eligold/SDTV2CSI/README.md

# ADV7280A-M Pi Analog Video to MIPI CSI-2 Hardware
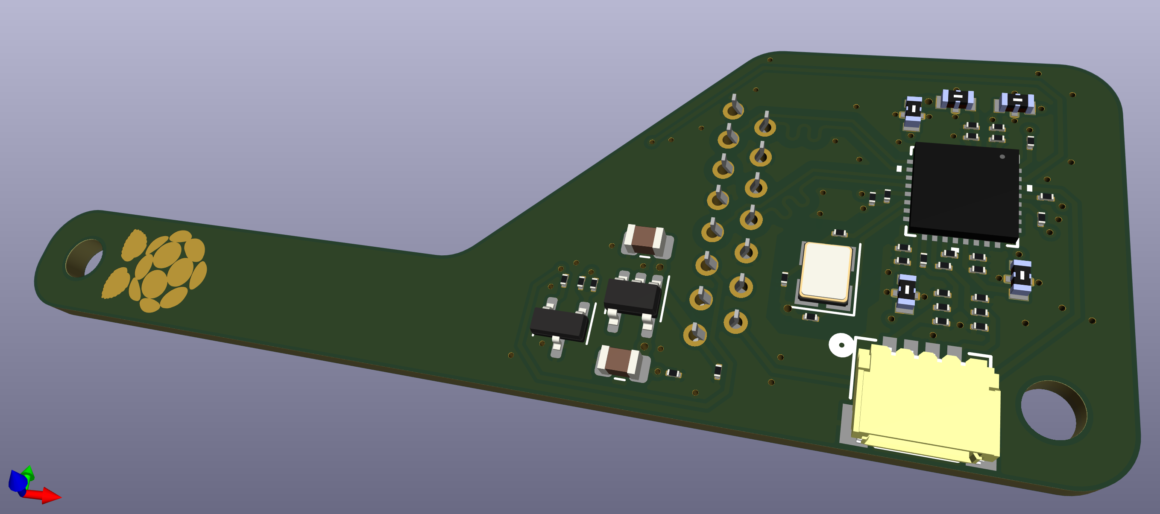
[picture p1: 3dstep.png]
3D view failed to load

<br>
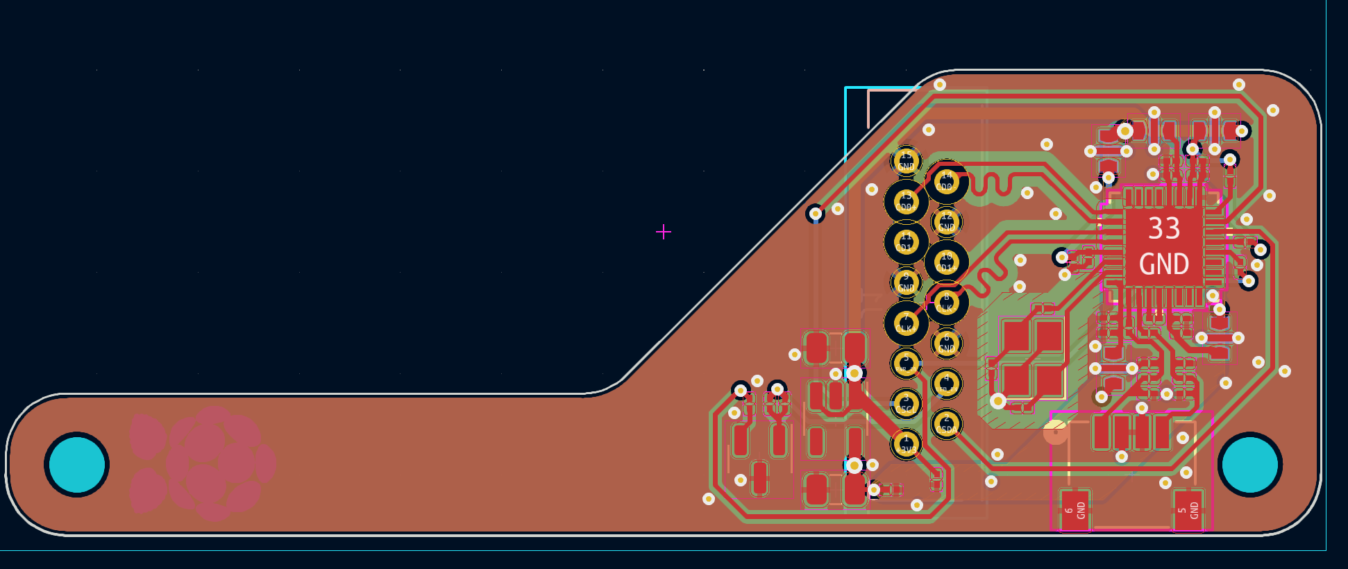
[picture p2: copperoutline.png]
copper image failed to load

<br>
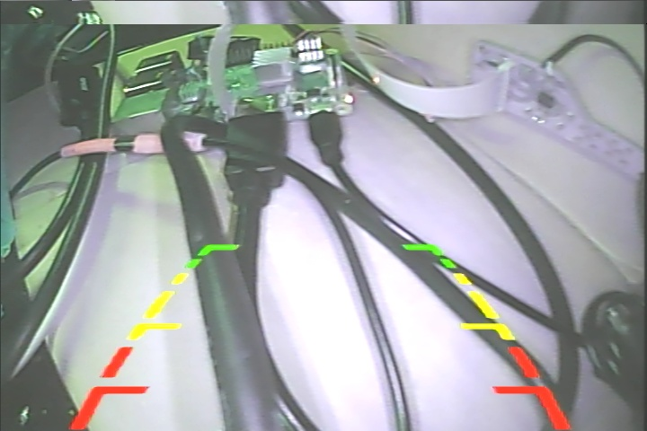
[picture p3: cap.jpg]
example capture failed to load

<br>
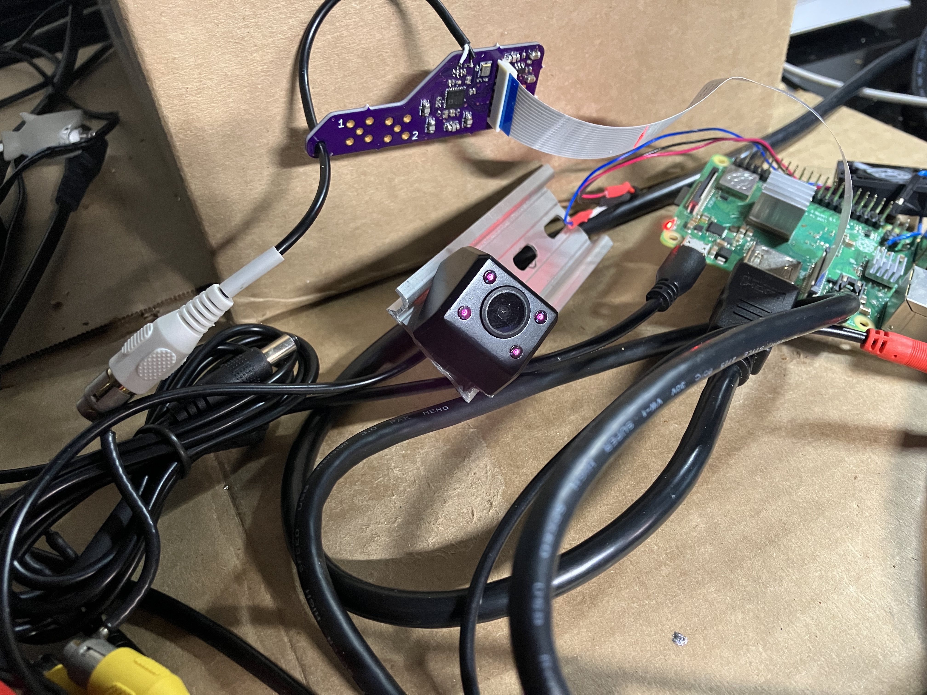
[picture p4: the.setup.jpg]
picture of the hardware setup failed to load
