eligold/SDTV2CSI/gerbers/C2C_r1_BOM.xlsx

Comment | Designator | Footprint | JLCPCB Part #
0.01μF | C1, C3, C6, C9, C11 | C0201 | C85930
0.1μF | C2, C5, C8, C10, C12, C13, C14, C16 | C0201 | C668346
20pF | C4, C7 | C0201 | C541317
2.7k | R1, R6, R24, R25, R26 | R0201 | C320800
24 | R2, R7 | R0201 | C295792
51 | R3, R9 | R0201 | C142007
560 | R23 | R0201 | C274340
TLV75718PDBV | U2 | SOT-23-5 | C507270
28.63636MHz | Y1 | SMD3225-4P | C501803
