eligold/SDTV2CSI/gerbers/C2C_r2_BOM.xlsx

Comment | Designator | Footprint | JLCPCB Part #
0.01μF | C1, C3, C6, C9, C11, C24, C27 | C0402 | C15195
0.1μF | C2, C5, C8, C10, C12, C13, C14, C16, C25, C26 | C0402 | C60474
20pF | C4, C7 | C0402 | C437436
47μF | C22, C23 | C0805 | C124129
4.7k | R1, R6, R24, R25, R26 | R0201 | C105870
24 | R2, R7 | R0201 | C274890
51 | R3, R9 | R0201 | C227127
560 | R23 | R0201 | C163460
TLV75718PDBV | U1 | SOT-23-5 | C507270
28.63636MHz | Y1 | SMD3225-4P | C501803
