eligold/SDTV2CSI/gerbers/Fabrication-C2C-r1.pdf

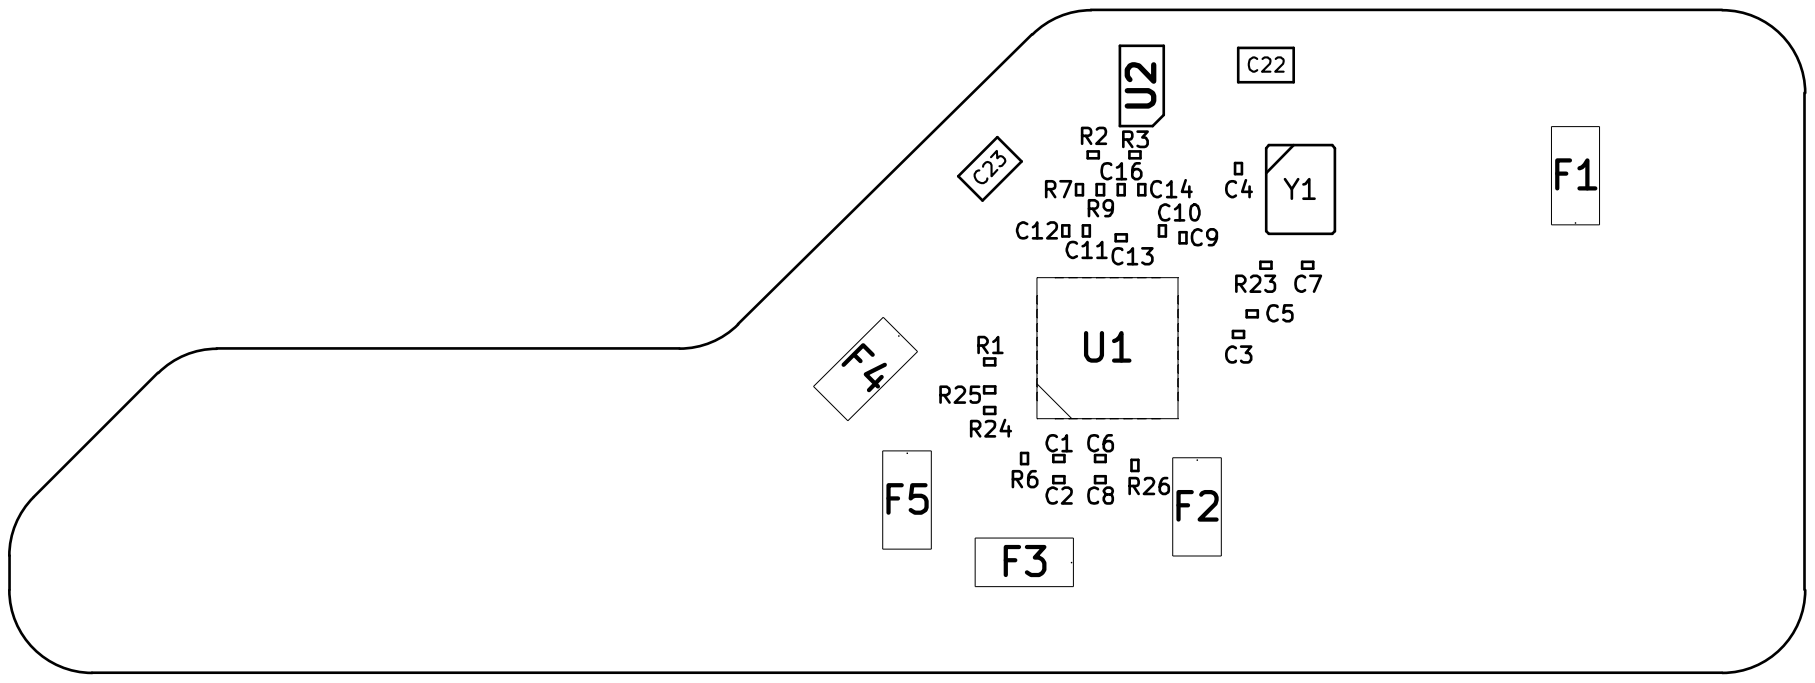
[picture p5: page 1]
