eligold/SDTV2CSI/SDTV2CSI.kicad_pcb

## KiCad design SDTV2CSI.kicad_pcb (2025-05-14)

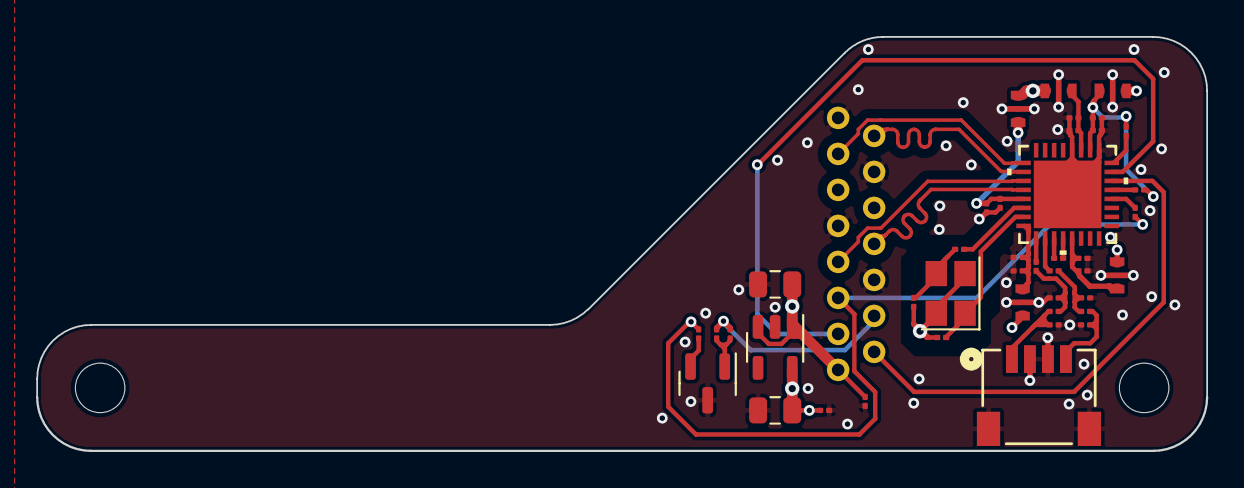
[picture p6: board SDTV2CSI.kicad_pcb from above]

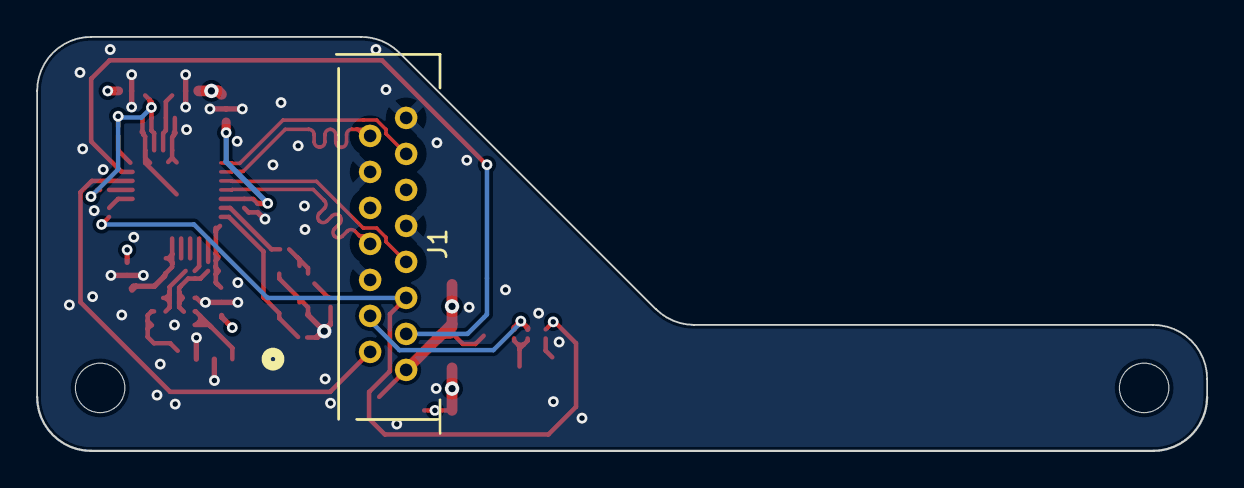
[picture p7: board SDTV2CSI.kicad_pcb from below]

Board: 4 copper layers, 65.0 x 23.0 mm, 44 parts (2 on the bottom side), 32 nets.

Parts:
C1, C3, C5, C7, C9: 0.01μF; R_0201_0603Metric
C2, C4, C6, C8, C10, C11, C12, C13: 0.1μF; R_0201_0603Metric
C14, C15: 100μF; C_0805_2012Metric
C16, C17: 20pF; R_0201_0603Metric
D1: 3VWM; R_0201_0603Metric
D2: 2VWM; R_0201_0603Metric
D3, D4: TVS; R_0201_0603Metric
D5: LED_Dual_AAK; SOT-23
F1, F2, F3, F4, F5: LC(Pi); MEM1608P25R0T001
J1: SFW15R-1STE1LF; 528061510
J2: SM04B-SRSS-TB; SM04B-SRSS-TB_JST
P1: Pi Zero; PIZERO
R1, R3: 24; R_0201_0603Metric
R2, R4: 51; R_0201_0603Metric
R5, R6, R7: 4.7k; R_0201_0603Metric
R8, R9, R10: 560; R_0201_0603Metric
R11: 220; R_0201_0603Metric
U1: ADV7280AWBCPZ-M; CP_32_12_ADI
U2: TLV75718; SOT-23-5
Y1: 28.63636MHz; Crystal_SMD_SeikoEpson_FA238-4Pin_3.2x2.5mm

Connections:
+1V8: C15.2, D2.1 (K), F2.1, F3.1, F4.1, F5.1, U2.5 (OUT)
+3V3: C14.2, D1.1 (K), F1.1, J1.1, U2.1 (IN), U2.3 (EN)
AVDD: C9.2, C10.1, F5.3, U1.21 (AVDD)
CD0+: J1.13, U1.9 (D0P)
CD0-: J1.14, U1.10 (D0N)
CLK+: J1.7, U1.11 (CLKP)
CLK-: J1.8, U1.12 (CLKN)
CSCL: J1.3, U1.31 (SCLK)
CSDA: J1.2, U1.30 (SDATA)
DVDD: C5.2, C6.1, F3.3, U1.3 (DVDD)
DVDDIO: C1.2, C2.1, F1.3, R6.1, R7.1, U1.2 (DVDDIO)
GND: C1.1, C2.2, C3.1, C4.2, C5.1, C6.2, C7.1, C8.2, C9.1, C10.2, C14.1, C15.1, C16.1, C17.1, D1.2 (A), D2.2 (A), D3.2 (A), D4.2 (A), D5.3 (K), F1.2_4, F2.2_4, F3.2_4, F4.2_4, F5.2_4, J1.6, J1.9, J1.12, J1.15, J2.2, J2.3, J2.5, J2.6, R2.1, R4.1, U1.1 (DGND), U1.4 (DGND), U1.33 (EPAD), U2.2 (GND), Y1.2, Y1.4
LED_EN: J1.4, R9.2, R10.2
MVDD: C3.2, C4.1, F2.3, U1.13 (MVDD)
unnamed: C11.2, R1.2, R2.2
unnamed: C12.2, R3.2, R4.2
unnamed: C13.1, U1.20 (VREFN)
unnamed: C13.2, U1.19 (VREFP)
unnamed: C17.2, R8.1, Y1.3
unnamed: D5.1 (A1), R9.1, R10.1
unnamed: D5.2 (A2), R11.1
unnamed: R5.1, U1.28 (*RESET)
unnamed: R6.2, U1.32 (*PWRDWN)
unnamed: R7.2, U1.29 (ALSB)
PVDD: C7.2, C8.1, F4.3, U1.16 (PVDD)
PWR_EN: J1.5, R5.2, R11.2
XN: C16.2, U1.15 (XTALN), Y1.1
XP: R8.2, U1.14 (XTALP)
video1: C11.1, U1.17 (AIN1)
video2: C12.1, U1.18 (AIN2)
video_in1: D3.1 (K), J2.1, R1.1
video_in2: D4.1 (K), J2.4, R3.1
