eligold/SDTV2CSI/(commit log)

2024-08-23 update and considering losing poe for waveshare OTS
    [SDTV2CSI.kicad_pcb, SDTV2CSI.kicad_sch]
2024-08-24 working on converting back to 0201
    [SDTV2CSI.kicad_pcb, SDTV2CSI.kicad_sch]
2024-08-25 will remove PoE components commit for posterity
    [SDTV2CSI.kicad_pcb, SDTV2CSI.kicad_sch]
2025-03-17 updating for GitHub
    [SDTV2CSI.kicad_pcb, SDTV2CSI.kicad_sch]
2025-05-14 latest iteration with smaller filters and bigger more secure footprint
    [C2C-B_Cu.gbr, C2C-B_Mask.gbr, C2C-Edge_Cuts.gbr, C2C-F_Cu.gbr, C2C-F_Mask.gbr, C2C-F_Paste.gbr, C2C-F_Silkscreen.gbr, C2C-In1_Cu.gbr]
